randel0/NEMA2K-Mast-Rotation-Compensator/IMG_4256.png

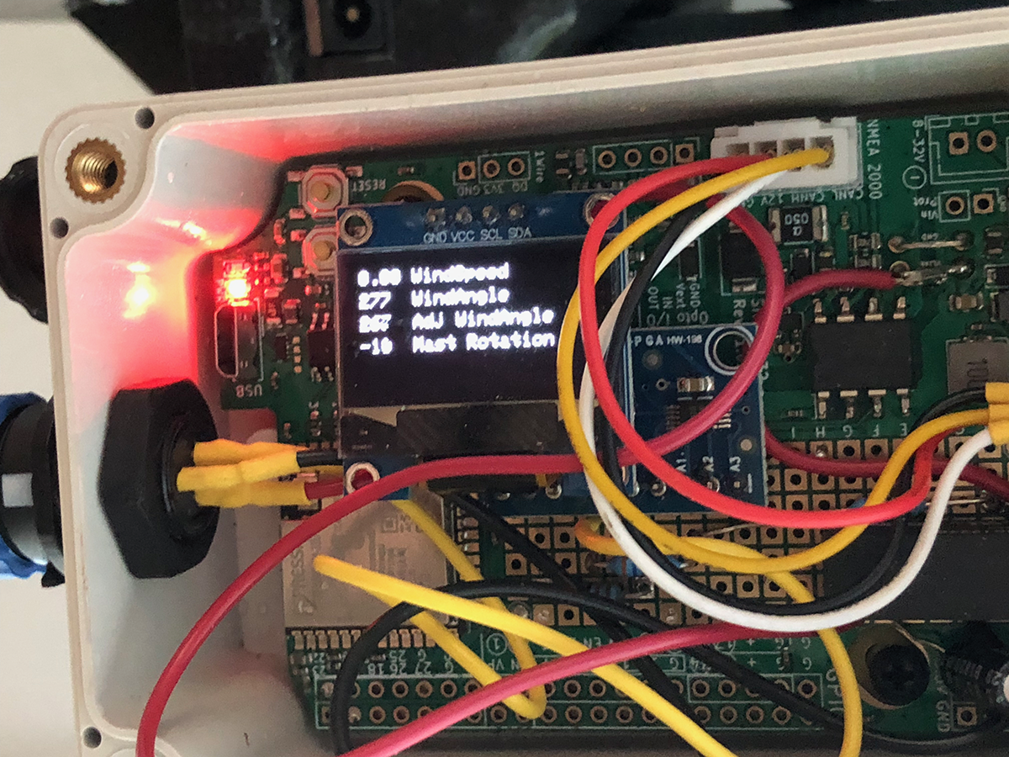
IMG_4256.png
