randel0/NEMA2K-Mast-Rotation-Compensator/IMG_4296.png

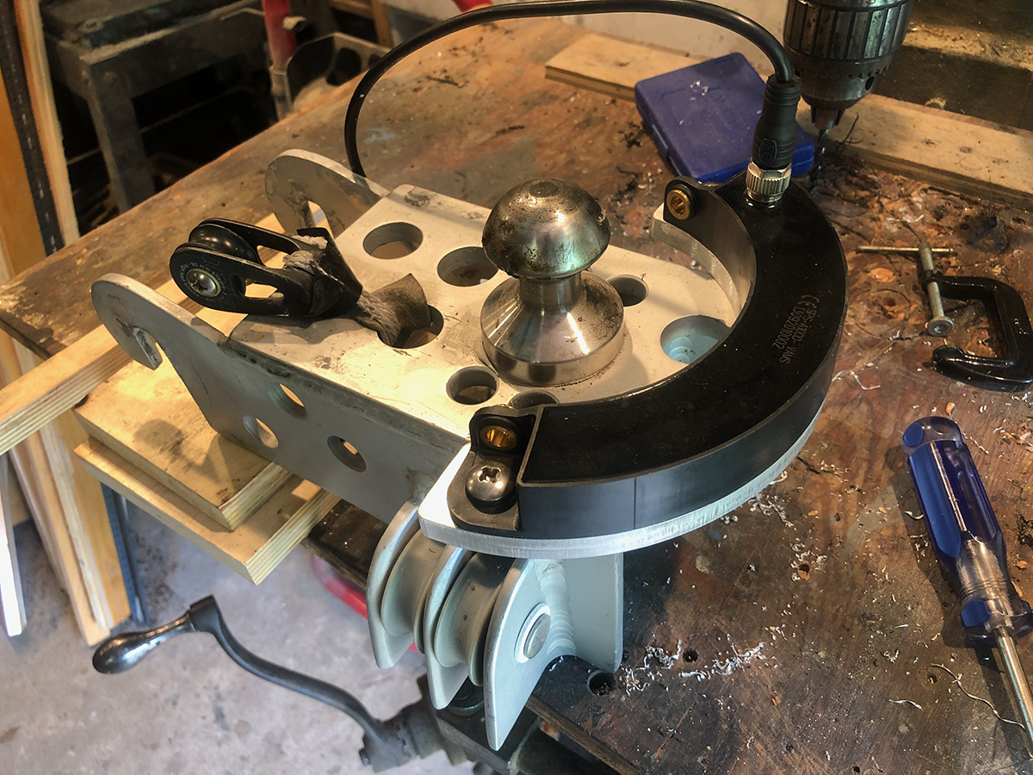
IMG_4296.png
