randel0/NEMA2K-Mast-Rotation-Compensator/ReadMe

NMEA 2000 Mast Rotation Compensator

The goal of this project is to create a small, rugged and relatively inexpensive solution to providing mast rotation-compensated apparent wind angle information to NMEA200 instruments.

A Honeywell Magnetic Position Sensor (https://sps.honeywell.com/us/en/products/advanced-sensing-technologies/aero-and-transportation-sensing/aero-and-transportation-sensors/motion-and-position-sensors/ma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) is used to measure the mast angle and translate it to a DC voltage. This sensor was chosen because of it's non-contact design, industrial design, and occasional availability on eBay at a deeply discounted price.

The sensor output is scaled through a resistor divider so the max voltage will not exceed 3.3VDC.

A Hat Labs ESP-32 development board (https://hatlabs.fi/product/sailor-hat-with-esp32) is used to house the divider and other peripherals. An ADS1115 ADC and 0.96" OLED display are connected to the processor via I2C.

The processor reads the voltage from the divider, smooths the data, and scales it to populate a variable that corresponds to the mast rotation angle, from -50° to +50°.

The processor parses incoming Apparent Wind Speed and Apparent Wind Angle data from the NME200 bus, and converts the angle data from radians to degrees.

The incoming angle data is added to the mast rotation angle, converted back to radians, and re-transmitted on the NMEA2000 bus along with the wind speed.

The Mast Rotation Compensator has it's own product code and ID, so instruments on the NMEA2000 network can select it as the source of AWS/AWD data.

Notes:

When uploading to the the Hat Labs board from the Arduino IDE, the board profile that worked for me is "DOIT ESP32 DEVKIT I", but only when I modified the upload speed to 115200.

The Hat Labs board has SDA and SCL on pins other than 21 and 22.  I modified the board to use thise pins.

My Honeywell sensor requires 24VDC for power.  I provided this with a small Murata DC-DC converter (https://www.mouser.com/ProductDetail/81-NMG1224SC) that I added to the Hat Labs board.

My instruments include a Nexus wind instrument with a Garmin GND-10 black box bridge and multiple Raymarine i70s displays.

I sail a Farrier F-32rx.
