randel0/NEMA2K-Mast-Rotation-Compensator/IMG_4315.png

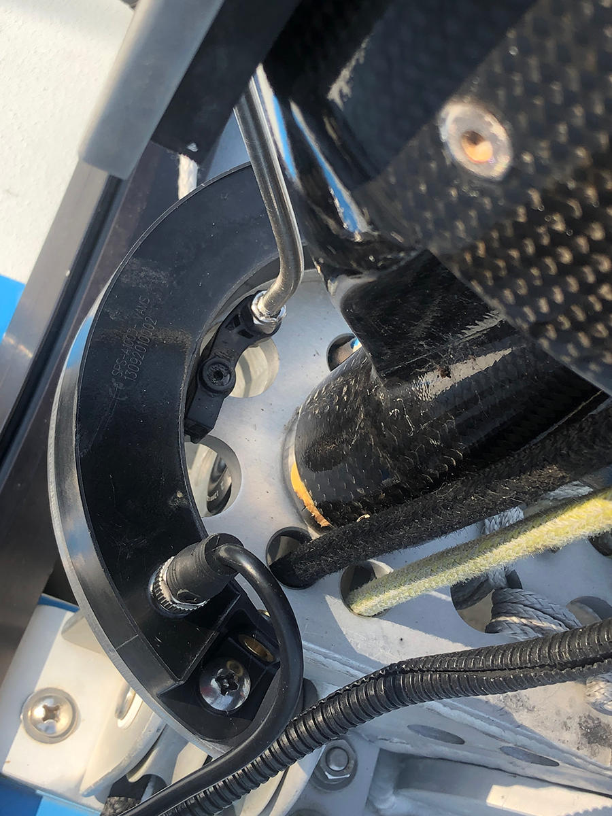
IMG_4315.png
