randel0/NEMA2K-Mast-Rotation-Compensator/IMG_4325.png

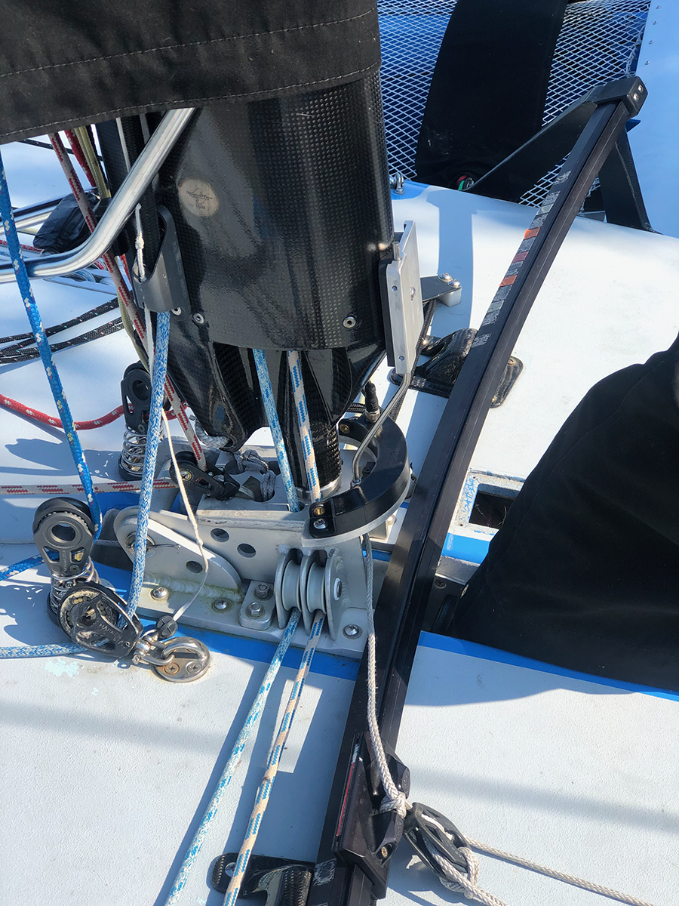
IMG_4325.png
