randel0/NEMA2K-Mast-Rotation-Compensator/IMG_4338.png

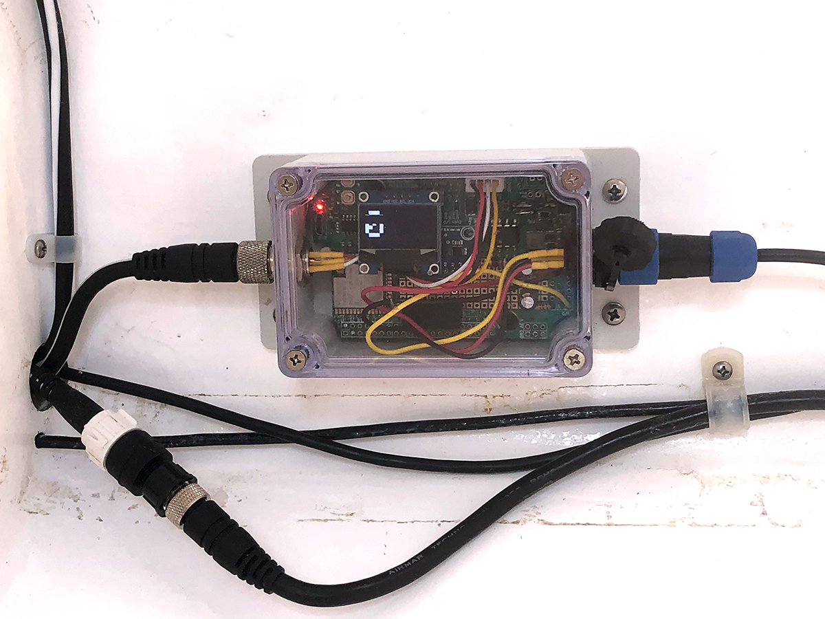
IMG_4338.png
