randel0/NEMA2K-Mast-Rotation-Compensator/Schematic.pdf

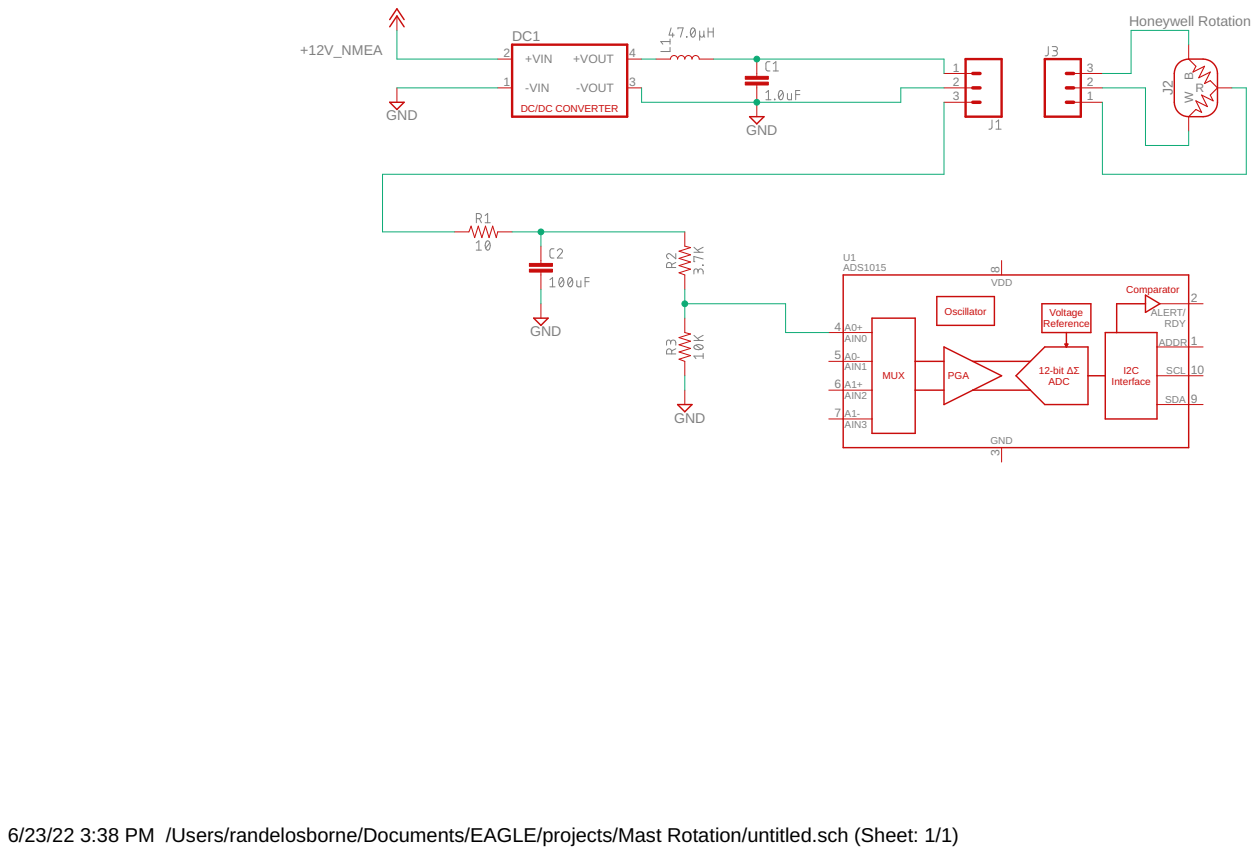
[picture p6: page 1]

6/23/22 3:38 PM /Users/randelosborne/Documents/EAGLE/projects/Mast Rotation/untitled.sch (Sheet: 1/1)
